nicolassaganias/BiodaphO2Tech/photos/WhatsApp Image 2025-06-20 at 17.59.41 (1).jpeg

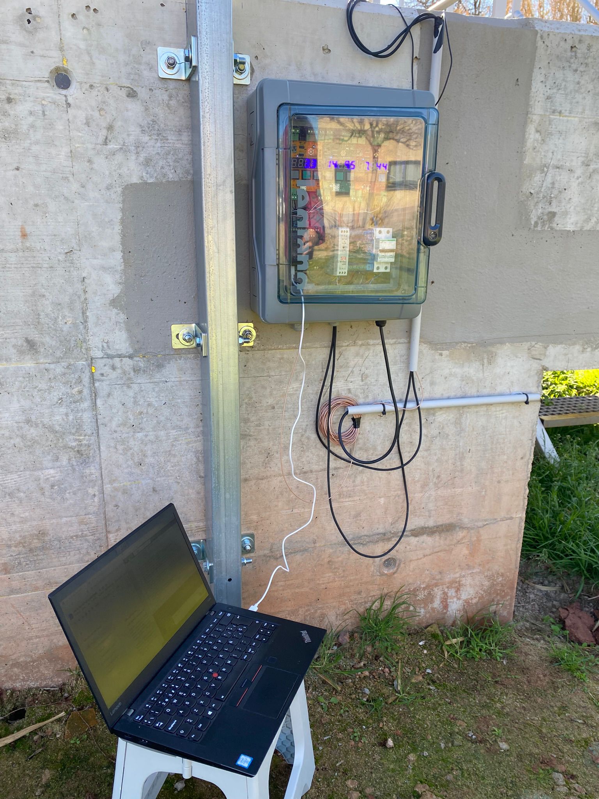
photos/WhatsApp Image 2025-06-20 at 17.59.41 (1).jpeg
