nicolassaganias/BiodaphO2Tech/documentation/Conections Diagram.pdf

# Caja Principal Caja Secundaria

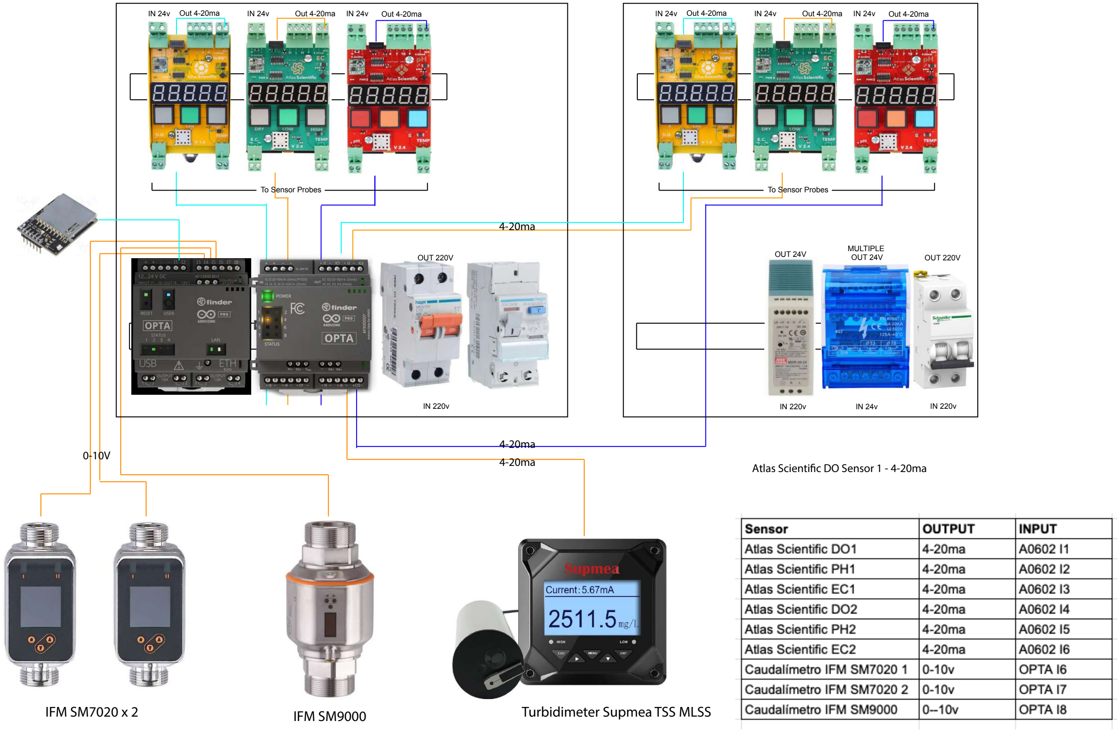
[picture p11: figure]
OUT 220V; 4-20ma output; MULTIPLE OUT 24V; Out 4-20ma; OUT 220V OUT 24V; To Sensor Probes; Atlas Scientic DO Sensor 1 - 4-20ma

IN 24v Out 4-20ma | IN 24v | Out 4-20ma IN 24v | Out 4-20ma
IFM SM9000 IFM SM7020 x 2 | Turbidimeter Supmea TSS MLSS
